kwan3217/rollercoasterometer/README.md

# rollercoasterometer
Rollercoasterometer
