kwan3217/rollercoasterometer/case/README.md

Design files for the case. Inkscape SVG for Ponoko, FreeCad for step export.
