kwan3217/rollercoasterometer/USB+ Breakout/README.md

# USB+ breakout
This is for *USB+*, which is designed to be USB 2.0, *plus* other stuff on the other pairs, using a USB 3.0 cable.

This board is intended to test the concept, by having a pocket and remote USB receptacle, with a 1.5m USB 3.0 cable
to be plugged into both.
