kwan3217/rollercoasterometer/ICM42688 breakout/README.md

# Breakout for ICM42688 sensor
A board was made from these files as they exist on 2022-04-14
