kwan3217/rollercoasterometer/kicad/README.md

# Folder for Kicad source code for rollercoasterometer boards
