kwan3217/rollercoasterometer/doc/New protection diode.png

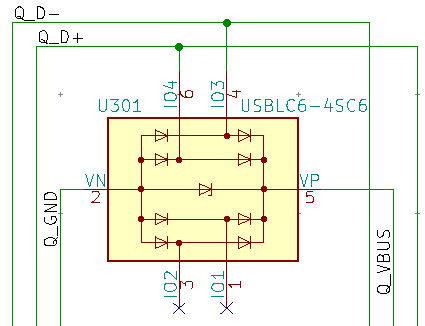
doc/New protection diode.png
