kwan3217/rollercoasterometer/doc/Protection diode routing.png

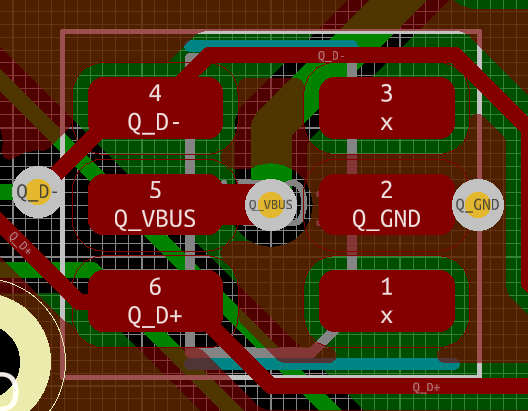
doc/Protection diode routing.png
