kwan3217/rollercoasterometer/case/Pocket Case.FCStd

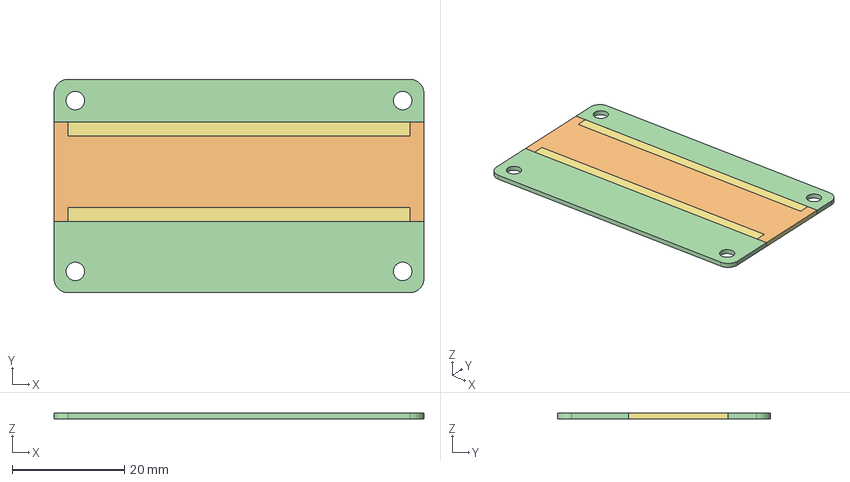
[picture p3: CAD file, 2022-04-28]
case/Pocket Case.FCStd
66.0 x 38.1 x 1.00 mm
EPlate
EThroughHoleSlots
EHoleUSBPlus
ESlot
EUSBSlot
EHole
EJoystick
