kwan3217/rollercoasterometer/kicad/joystick.step

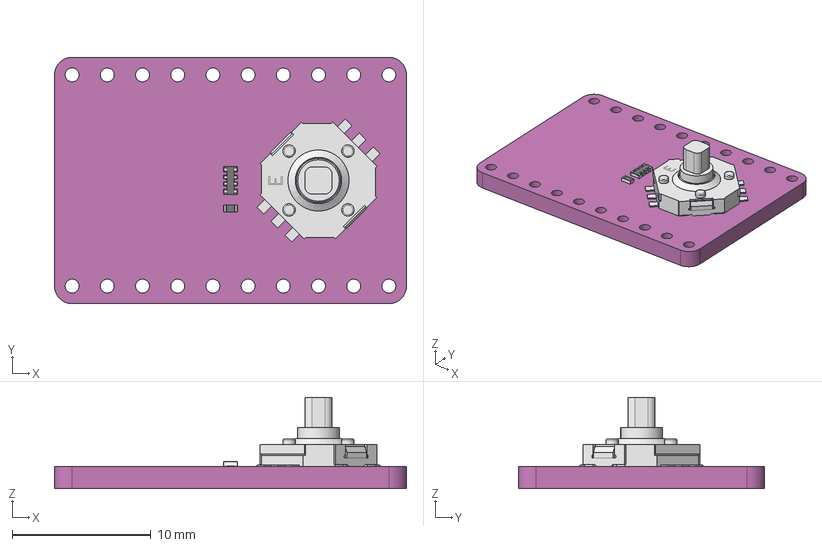
[picture p4: CAD file, 2022-04-25]
kicad/joystick.step
25.4 x 17.8 x 6.59 mm
Pcb_d5d7
S3501_JS1400BFQ_b402e1f153ac
R3502_R_0402_1005Metric_25f31b7644c3
R3501_R_Array_Convex_4x0402_d6afd14049a0
