kwan3217/rollercoasterometer/case/Pocket Case-Slot.step

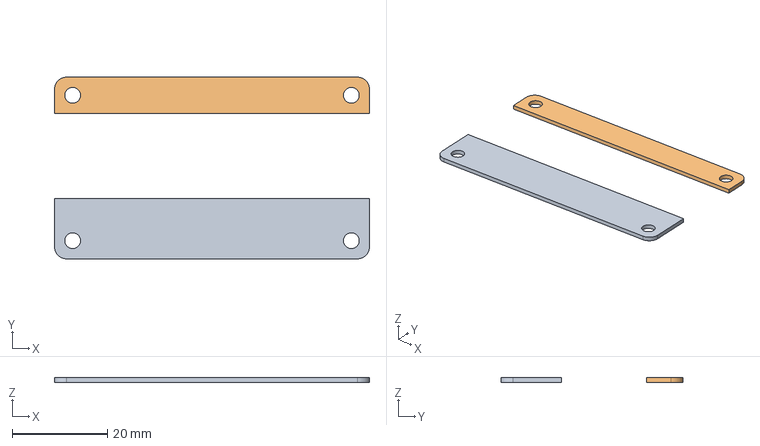
[picture p5: CAD file, 2022-04-28]
case/Pocket Case-Slot.step
66.0 x 38.1 x 1.00 mm
