kwan3217/rollercoasterometer/case/Pocket Case-Joystick.step

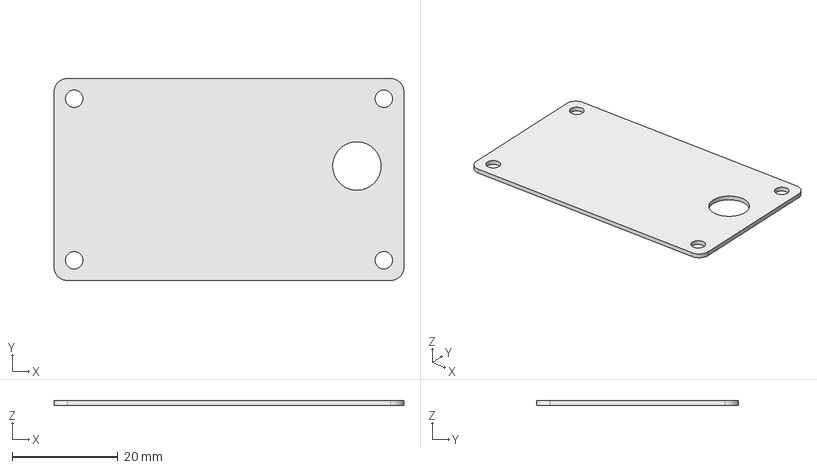
[picture p7: CAD file, 2022-04-28]
case/Pocket Case-Joystick.step
66.0 x 38.1 x 1.00 mm
