kwan3217/rollercoasterometer/case/Pocket Case-USBPlus.step

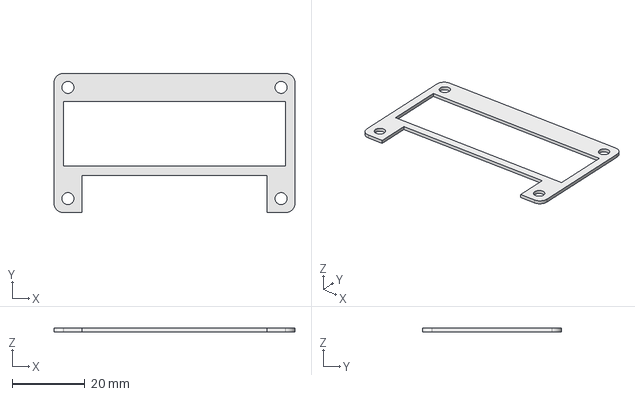
[picture p9: CAD file, 2022-04-28]
case/Pocket Case-USBPlus.step
66.0 x 38.1 x 1.00 mm
