kwan3217/rollercoasterometer/case/Pocket Case-USBSlot.step

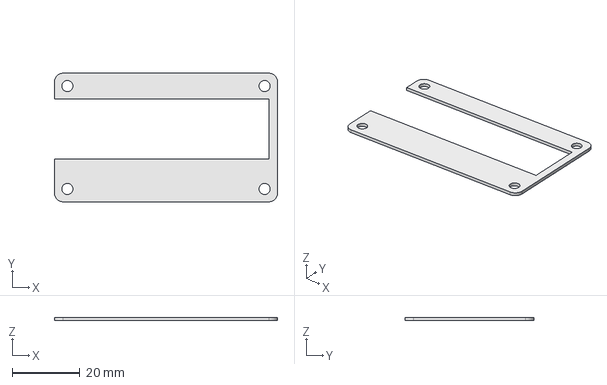
[picture p10: CAD file, 2022-04-28]
case/Pocket Case-USBSlot.step
66.0 x 38.1 x 1.00 mm
