kwan3217/rollercoasterometer/case/Pocket Case-Plate.step

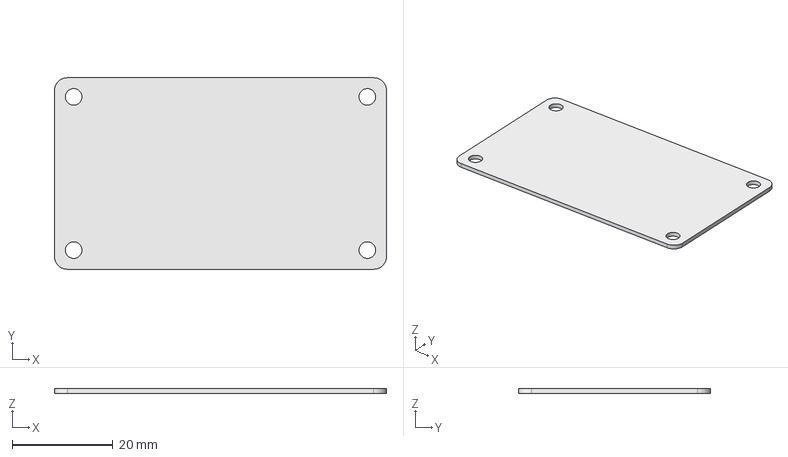
[picture p11: CAD file, 2022-04-28]
case/Pocket Case-Plate.step
66.0 x 38.1 x 1.00 mm
