kwan3217/rollercoasterometer/kicad/rollercoasterometer_hat/rollercoasterometer_hat.kicad_pcb

## KiCad design kicad/rollercoasterometer_hat/rollercoasterometer_hat.kicad_pcb (2022-12-18)

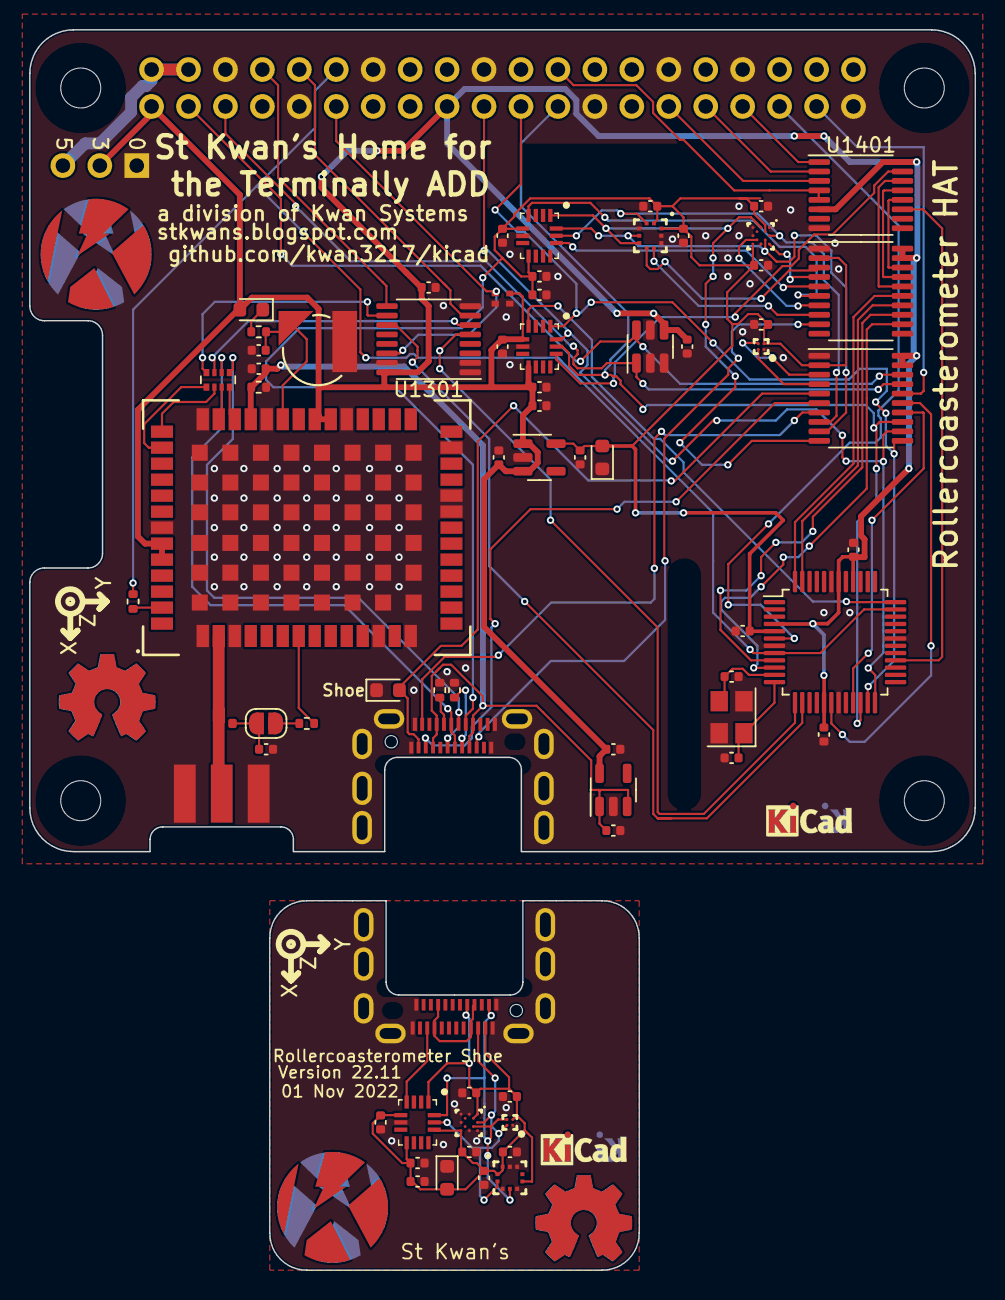
[picture p12: board rollercoasterometer_hat.kicad_pcb from above]

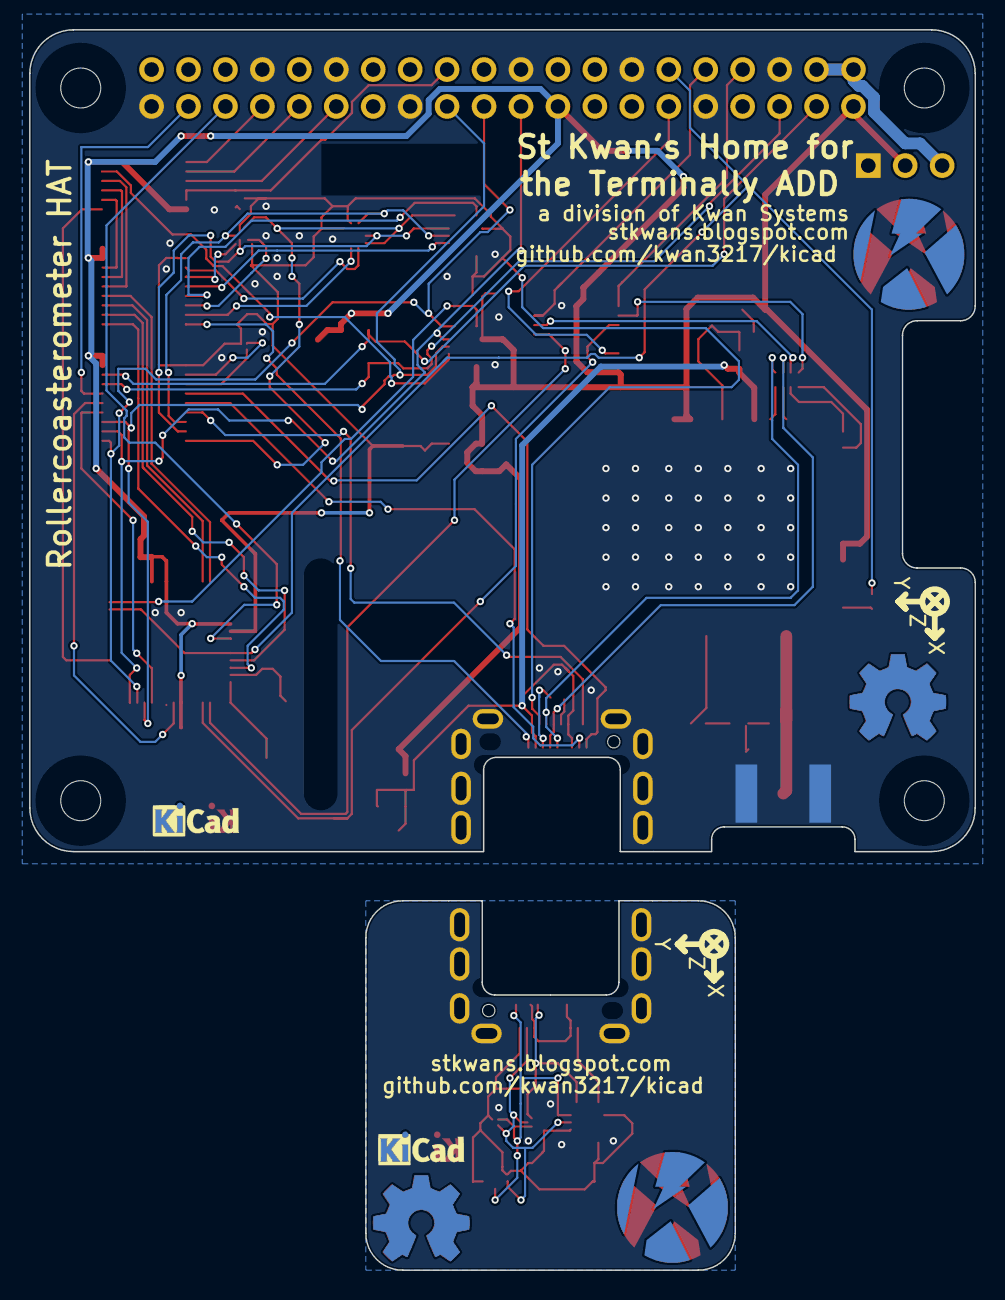
[picture p13: board rollercoasterometer_hat.kicad_pcb from below]

Board: 2 copper layers, 65.0 x 56.5 mm, 86 parts (6 on the bottom side), 73 nets.

Parts:
B201: ML414H; Coin_Cell_ML414H
C201: 47pF; C_0402_1005Metric
C236, C238, C401, C405, C501, C505: 1uF; C_0402_1005Metric
C605, C805, C1605: 10nF; C_0402_1005Metric
C606, C806, C1606: 2.2uF; C_0402_1005Metric
C608, C704, C808, C922, C955, C1011, C1101, C1110, C1205, C1217, C1240, C1301, C1608, C1722, C1755, C1811, C1901, C1910: 100nF; C_0402_1005Metric
C1211, C1212: 22pF; C_0402_1005Metric
D201: 0.5A/420mV; D_0603_1608Metric
D301, D302, D501: RED; LED_0603_1608Metric
G101, G1501: Axis
G102, G105, G1502, G1505: KwanSystems; StKwansSoldermask
G103, G107, G1503, G1507: DesignedWithKicad; Symbol_KiCAD-Logo_CopperAndSilkScreenTop_small
G104, G106, G1504, G1506: OSHW; OSHW-Symbol_6.7x6mm_SolderMask
J101: Raspberry_Pi_40; PiHAT
J102: Conn_01x03; PinHeader_1x03_P2.54mm_Horizontal
J201: SMA; SMA-EDGE
J202: NormallyClosed; SolderJumper-2_P1.3mm_MaskBridged_RoundedPad1.0x1.5mm
J301, J302: USB_C_Receptacle; USB_C_Amphenol_MidMount_with_cutout
L201: Ferrite 120NH; L_0402_1005Metric
R238: 100k; R_0402_1005Metric
R239: 27; R_Array_Convex_4x0402
R253, R407: 27; R_0402_1005Metric
R301, R302, R436: 5.1k; R_0402_1005Metric
R1301: 10k; R_Array_Convex_2x0402
U201: ZED_F9R; ZED-F9x
U401: TCR2EF 3.3V; SOT-23-5
U501: TCR2EF 1.8V; SOT-23-5
U601, U801, U1601: ICM-42688; QFN50P300X250X97-14N
U701: TLE493D-W2B6; SOT-23-6
U901, U1701: BMM150
U1001, U1801: AK09918; AK09918C
U1101, U1901: BMP384
U1201: LPC2103; LQFP-48_7x7mm_P0.5mm
U1301: 743253; TSSOP-16_4.4x5mm_P0.65mm
U1401: 74LS138; TSSOP-16_4.4x5mm_P0.65mm
U1402, U1403: TXS0108; TSSOP-20_4.4x6.5mm_P0.65mm
Y1201: 12MHz; Crystal_SMD_Abracon_ABM8G-4Pin_3.2x2.5mm

Connections:
+1V8: C505.1, C805.1, C806.1, C808.1, C922.1, C955.1, C1011.1, C1101.1, C1110.1, C1205.1, D501.2 (A), J301.A8 (SBU1), U501.5 (OUT), U801.5 (VDDIO), U801.8 (VDD), U901.B2 (VDDIO), U901.E5 (VDD), U1001.B1 (VDD), U1101.1 (VDDIO), U1101.10 (VDD), U1201.5 (VDD(1V8)), U1402.2 (VLO), U1403.2 (VLO)
+3V3: C405.1, C501.1, C605.1, C606.1, C608.1, C704.1, C1217.1, C1240.1, C1301.1, D201.2 (A), J101.1 (3V3), J101.17 (3V3), J102.2, R1301.4 (3), U201.33 (VCC), U201.34 (VCC), U201.49 (~RESET), U201.50 (~SAFEBOOT), U401.5 (OUT), U501.1 (IN), U501.3 (EN), U601.5 (VDDIO), U601.8 (VDD), U701.4 (VDD), U1201.4 (VBAT), U1201.17 (VDD(3V3)), U1201.40 (VDD(3V3)), U1201.42 (VDDA), U1301.16 (VCC), U1401.6 (E3), U1401.16 (VCC), U1402.19 (VHI), U1402.20 (EN), U1403.19 (VHI), U1403.20 (EN)
+5V: J101.2 (5V), J101.4 (5V), J102.3
/Bus Level Converter/~CS_6D18_3V3: U1401.14 (O1), U1402.16 (B3)
/Bus Level Converter/~CS_BMM_3V3: U1401.13 (O2), U1402.17 (B2)
/Bus Level Converter/~CS_BMP_3V3: U1401.12 (O3), U1402.18 (B1)
/CS0: J101.33 ((PWM1)_GPIO13), U1401.1 (A0)
/CS1: J101.31 (GPIO6), U1401.2 (A1)
/CS2: J101.29 (GPIO5), U1401.3 (A2)
/D+: J301.A6 (D+), J301.B6 (D+), R239.2 (4)
/D-: J301.A7 (D-), J301.B7 (D-), R239.1 (4)
/DRDY_6D18_1V8: U801.4 (INT1), U1402.6 (A4)
/DRDY_6D18_3V3: U1201.48 ((CAP1.3/SDA1)P0.18), U1402.15 (B4)
/DRDY_6D33_3V3: U601.4 (INT1), U1201.36 ((CTS1/CAP1.1/AD0.4)P0.11)
/DRDY_BMM_1V8: U901.D4 (DRDY), U1402.7 (A5)
/DRDY_BMM_3V3: U1201.47 ((CAP1.2/SCL1)P0.17), U1402.14 (B5)
/DRDY_BMP_1V8: U1101.7 (INT), U1402.8 (A6)
/DRDY_BMP_3V3: U1201.9 ((TMS/CAP2.1)P0.28), U1402.13 (B6)
/GPS/DM-: R239.8 (5), U201.39 (USB_D-)
/GPS/DP-: R239.7 (5), U201.40 (USB_D+)
/GPS/RF_IN: J201.1 (In), L201.1, U201.2 (RF_IN)
/GPS/RX/MOSI-: R239.5, U201.43 (RX/MOSI)
/GPS/TIMEPULSE-: R253.1, U201.53 (TIMEPULSE)
/GPS/TX/MISO-: R239.6 (5), U201.42 (TX/MISO)
/GPS/VBAT+: D201.1 (K), R436.1
/GPS/V_BATT: B201.1 (+), C236.1, R436.2, U201.36 (V_BKCP)
/GPS/V_RF: R407.2, U201.7 (VCC_RF)
/GPS/V_RF-: J202.2 (B), R407.1
/GPS/V_RF--: C201.1, J202.1 (A), L201.2
/GPS_RX: R239.4, U1301.10 (2B1)
/GPS_TX: R239.3 (4), U1301.6 (1B1)
/LPC_RX: U1201.14 ((RXD0/MAT3.2)P0.1), U1301.11 (2B2)
/LPC_TX: U1201.13 ((TXD0/MAT3.1)P0.0), U1301.5 (1B2)
/LPC_~RESET: J101.35 ((MISO)_GPIO19), U1201.6 (~RST)
/MISO_1V8: U801.1 (AD0), U901.C1 (SDO), U1101.5 (SDO), U1403.10 (A8)
/MISO_3V3: J101.21 ((SPI_MISO)_GPIO9), U601.1 (AD0), U1201.23 ((MISO0/MAT0.1)P0.5), U1403.11 (B8)
/MOSI_1V8: U801.14 (SDA), U901.B4 (SDI), U1101.4 (SDI), U1403.9 (A7)
/MOSI_3V3: J101.19 ((SPI_MOSI)_GPIO10), U601.14 (SDA), U1201.24 ((MOSI0/CAP0.2)P0.6), U1403.12 (B7)
/PPS: J101.12 (GPIO18_(GEN1)), R253.2, U1201.8 ((~TRST/CAP2.0)P0.27), U1201.35 ((RTS1/CAP1.0/AD0.3)P0.10)
/P_RET_1V8: D301.2 (A), J301.B11 (RX1+), U1403.5 (A3)
/P_RET_3V3: J101.37 (GPIO26), U1403.16 (B3)
/Q_1V8: C1605.1, C1606.1, C1608.1, C1722.1, C1755.1, C1811.1, C1901.1, C1910.1, D302.2 (A), J302.A2 (TX1+), J302.B8 (SBU2), U1601.1 (AD0), U1601.5 (VDDIO), U1601.8 (VDD), U1601.12 (~CS), U1701.A1 (PS), U1701.B2 (VDDIO), U1701.E5 (VDD), U1801.B1 (VDD), U1901.1 (VDDIO), U1901.6 (CSB), U1901.10 (VDD)
/Q_GND: C1605.2, C1606.2, C1608.2, C1722.2, C1755.2, C1811.2, C1901.2, C1910.2, D302.1 (K), J302.A1 (GND), J302.A12 (GND), J302.B1 (GND), J302.B12 (GND), J302.S1 (SHIELD), U1601.6 (GND), U1701.A5 (CSB), U1701.C1 (SDO), U1701.C5 (GND), U1701.E1 (GND), U1701.E3 (GND), U1801.A1 (VSS), U1901.3 (VSS), U1901.5 (SDO), U1901.8 (VSS), U1901.9 (VSS)
/Q_SCL_1V8: J302.A3 (TX1-), U1601.13 (SCL), U1701.A3 (SCK), U1801.A2 (SCL), U1901.2 (SCK)
/Q_SDA_1V8: J302.B11 (RX1+), U1601.14 (SDA), U1701.B4 (SDI), U1801.B2 (SDA), U1901.4 (SDI)
/Q_SHOE_INT: J302.A10 (RX2-), U1601.4 (INT1)
/RX_PI: J101.10 ((RXD0)_GPIO15), U1301.7 (1A)
/SCK_1V8: U801.13 (SCL), U901.A3 (SCK), U1101.2 (SCK), U1403.8 (A6)
/SCK_3V3: J101.23 ((SPI_SCLK)_GPIO11), U601.13 (SCL), U1201.22 ((SCK0/CAP0.1)P0.4), U1403.13 (B6)
/SCL_LPC_1V8: J301.B10 (RX1-), U1403.6 (A4)
/SCL_LPC_3V3: U1201.18 ((SCL0/CAP0.0)P0.2), U1403.15 (B4)
/SCL_PI_1V8: U1001.A2 (SCL), U1403.4 (A2)
/SCL_PI_3V3: J101.5 ((SCL1)_GPIO3), U701.1 (SCL/INT), U1403.17 (B2)
/SDA_LPC_1V8: J301.A2 (TX1+), U1403.7 (A5)
/SDA_LPC_3V3: U1201.21 ((SDA0/MAT0.0)P0.3), U1403.14 (B5)
/SDA_PI_1V8: U1001.B2 (SDA), U1403.3 (A1)
/SDA_PI_3V3: J101.3 ((SDA1)_GPIO2), U701.6 (SDA), U1403.18 (B1)
/SHOE_INT_1V8: J301.B3 (TX2-), U1402.9 (A7)
/SHOE_INT_3V3: U1201.10 ((TCK/CAP2.2)P0.29), U1402.12 (B7)
/TX_PI: J101.8 ((TXD0)_GPIO14), U1301.9 (2A)
/Timer/XTAL1: C1211.2, U1201.11 (XTAL1), Y1201.3
/Timer/XTAL2: C1212.2, U1201.12 (XTAL2), Y1201.1
/UART_S0: J101.11 (GPIO17_(GEN0)), R1301.1 (4), U1301.14 (S0)
/USB+ Cable/P_CC1: J301.A5 (CC1), R302.2
/USB+ Cable/P_CC2: J301.B5 (CC2), R301.2
/VBUS: C238.1, C401.1, J301.A4 (VBUS), J301.A9 (VBUS), J301.B4 (VBUS), J301.B9 (VBUS), R238.2, U201.38 (V_USB), U401.1 (IN), U401.3 (EN)
/~CE0: J101.24 ((~SPI_CE0)_GPIO8), U1401.4 (E1), U1401.5 (E2)
/~CS_6D18_1V8: U801.12 (~CS), U1402.5 (A3)
/~CS_6D33: U601.12 (~CS), U1401.15 (O0)
/~CS_BMM_1V8: U901.A5 (CSB), U1402.4 (A2)
/~CS_BMP_1V8: U1101.6 (CSB), U1402.3 (A1)
/~CS_LPC_3V3: U1201.28 ((SSEL0/MAT2.0)P0.7), U1401.11 (O4)
GND: B201.2 (-), C201.2, C236.2, C238.2, C401.2, C405.2, C501.2, C505.2, C605.2, C606.2, C608.2, C704.2, C805.2, C806.2, C808.2, C922.2, C955.2, C1011.2, C1101.2, C1110.2, C1205.2, C1211.1, C1212.1, C1217.2, C1240.2, C1301.2, D301.1 (K), D501.1 (K), J101.6 (GND), J101.9 (GND), J101.14 (GND), J101.20 (GND), J101.25 (GND), J101.30 (GND), J101.34 (GND), J101.39 (GND), J102.1, J201.2 (Ext), J301.A1 (GND), J301.A12 (GND), J301.B1 (GND), J301.B12 (GND), J301.S1 (SHIELD), R238.1, R301.1, R302.1, R1301.2 (4), R1301.3, U201.1 (GND), U201.3 (GND), U201.12 (GND), U201.14 (GND), U201.22 (WT), U201.23 (DIR), U201.26 (RX2), U201.32 (GND), U201.37 (GND), U201.41 (GND), U201.48 (GND), U201.PAD (GND), U401.2 (GND), U501.2 (GND), U601.6 (GND), U701.2 (GND), U701.3 (GND), U701.5 (GND), U801.6 (GND), U901.A1 (PS), U901.C5 (GND), U901.E1 (GND), U901.E3 (GND), U1001.A1 (VSS), U1101.3 (VSS), U1101.8 (VSS), U1101.9 (VSS), U1201.7 (VSS), U1201.19 (VSS), U1201.31 (VSSA), U1201.43 (VSS), U1301.1 (1~OE), U1301.2 (S1), U1301.8 (GND), U1301.15 (2~OE), U1401.8 (GND), U1402.1 (GND), U1403.1 (GND), Y1201.2, Y1201.4
