kwan3217/rollercoasterometer/kicad/rollercoasterometer.kicad_pcb

## KiCad design kicad/rollercoasterometer.kicad_pcb (2022-12-18)

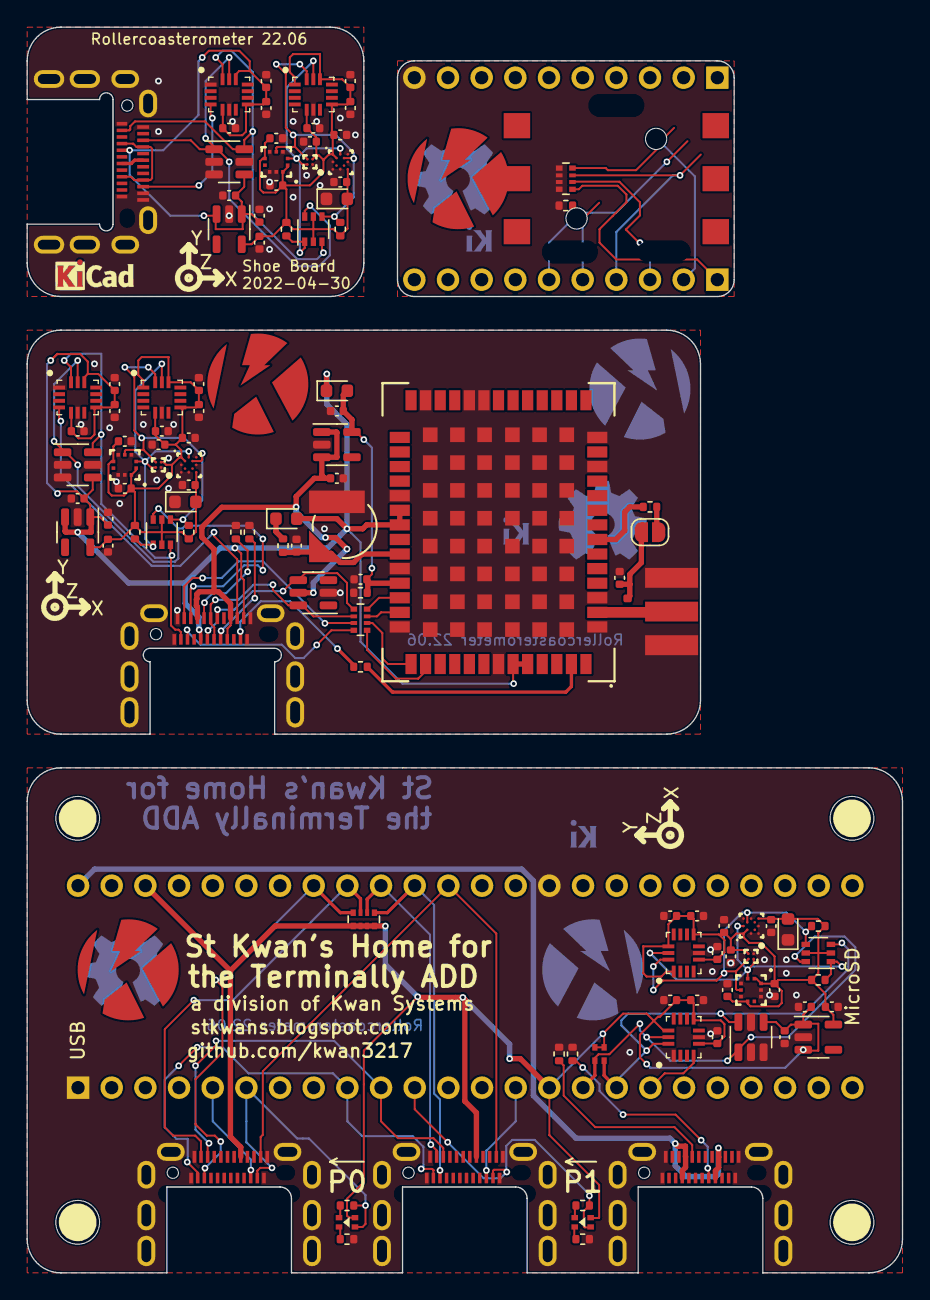
[picture p14: board rollercoasterometer.kicad_pcb from above]

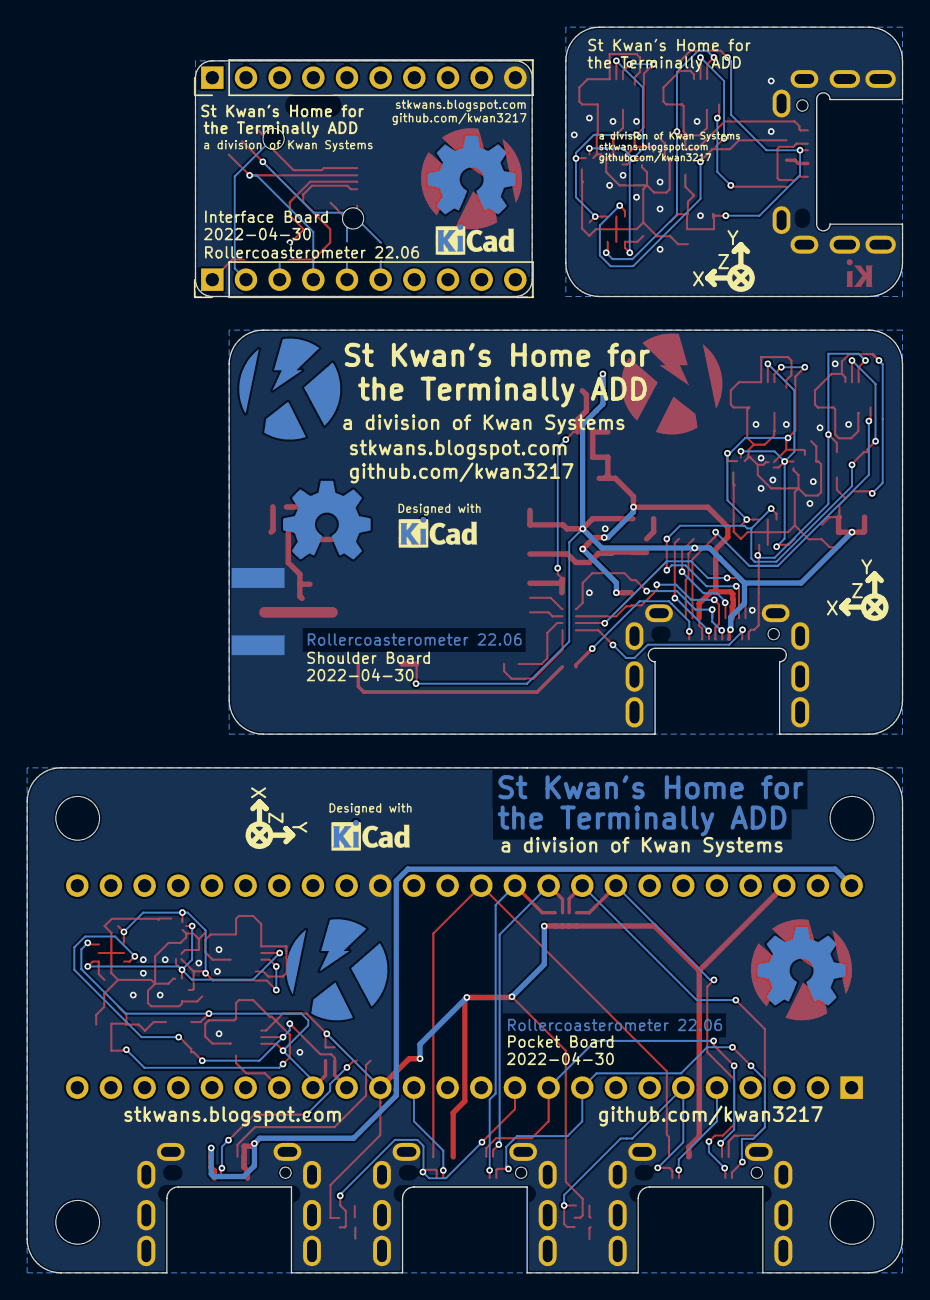
[picture p15: board rollercoasterometer.kicad_pcb from below]

Board: 2 copper layers, 66.0 x 94.0 mm, 136 parts (10 on the bottom side), 72 nets.

Parts:
B401: ML414H; Coin_Cell_ML414H
C205, C1205, C1305, C2105, C2705, C3205: 10nF; C_0402_1005Metric
C206, C1206, C1306, C2106, C2706, C3206: 2.2uF; C_0402_1005Metric
C208, C611, C704, C901, C910, C1122, C1155, C1208, C1308, C1804, C2108, C2322, C2355, C2411, C2501, C2510, C2708, C2804, C2901, C2910, C3208, C3322, C3355, C3411: 100nF; C_0402_1005Metric
C401: 47pF; C_0402_1005Metric
C436, C438, C501, C505, C1001, C1005, C1901, C1905, C3001, C3005: 1uF; C_0402_1005Metric
D338, D401: 0.5A/420mV; D_0603_1608Metric
D1001, D1905, D3001: RED; LED_0603_1608Metric
D1401, D1601: GREEN, YELLOW; LEDKingbrightAPHB
G101, G102, G301, G302, G3502: KwanSystems; StKwansSoldermask
G103, G303, G1501, G3503: DesignedWithKicad; Symbol_KiCAD-Logo_CopperAndSilkScreenTop_small
G104, G304, G3504: OSHW; OSHW-Symbol_6.7x6mm_SolderMask
G105, G305, G1505: Axis
J101, J1401, J1402, J1601, J1602: USB_C_Receptacle; USB_C_Amphenol_MidMount
J120, J125, J127, J129: STANDOFF; STANDOFF_NONPLATED
J401: SMA; SMA-EDGE
J402: NormallyClosed; SolderJumper-2_P1.3mm_MaskBridged_RoundedPad1.0x1.5mm
J3501, J3502: Conn_01x10; PinHeader_1x10_P2.54mm_Vertical
L401: Ferrite 120NH; L_0402_1005Metric
Q801, Q2001, Q3101: NMOS; SOT-363_SC-70-6
R101, R102, R301, R302, R436, R801, R802, R2001, R2002, R3101, R3102, R3502: 5.1k; R_0402_1005Metric
R116: 2.2k; R_Array_Convex_2x0402
R138, R3501: 2.2k; R_Array_Convex_4x0402
R407, R453: 27; R_0402_1005Metric
R438: 100k; R_0402_1005Metric
R439: 27; R_Array_Convex_4x0402
R1401, R1601: 330; R_0402_1005Metric
R1402, R1602: 1.5k; R_0402_1005Metric
S3501: JS5208
U104: Teensy4.1; Teensy2x24
U201, U1201, U1301, U2101, U2701, U3201: ICM-42688; QFN50P300X250X97-14N
U301: USBLC6-4SC6; SOT-23-6
U401: ZED_F9R; ZED-F9x
U501: TCR2EF 3.3V; SOT-23-5
U601, U2401, U3401: AK09918; AK09918C
U704, U1801, U2801: TLE493D-W2B6; SOT-23-6
U901, U2501, U2901: BMP384
U1001, U1901, U3001: TCR2EF 1.8V; SOT-23-5
U1101, U2201, U3301: BMM150

Connections:
+3V3: C2705.1, C2706.1, C2708.1, C2804.1, C3001.1, D1401.3 (A2), D1601.3 (A2), J1401.A8 (SBU1), J1601.A8 (SBU1), R116.3, R116.4 (3), R138.5, R138.6 (5), R138.7 (5), R138.8 (5), U104.15 (+3V3), U104.46 (+3V3), U2701.5 (VDDIO), U2701.8 (VDD), U2701.12 (~CS), U2801.4 (VDD), U3001.1 (IN), U3001.3 (EN)
+5V: J101.A4 (VBUS), J101.A9 (VBUS), J101.B4 (VBUS), J101.B9 (VBUS), U104.48 (Vin)
/CC1: J101.A5 (CC1), R101.2
/CC2: J101.B5 (CC2), R102.2
/Joystick/Q_3V3: J3501.6, S3501.COM
/Joystick/Q_DOWN: J3501.3, R3501.6 (5), S3501.C
/Joystick/Q_GND: J3502.10, R3501.1 (4), R3501.2 (4), R3501.3 (4), R3501.4, R3502.1
/Joystick/Q_LEFT: J3501.5, R3502.2, S3501.A
/Joystick/Q_PUSH: J3501.1, R3501.5, S3501.PUSH
/Joystick/Q_RIGHT: J3501.4, R3501.7 (5), S3501.D
/Joystick/Q_UP: J3501.2, R3501.8 (5), S3501.B
/P0_ID: D1401.1 (A1), J1401.B2 (TX2+), R1402.2, U104.6 (D4~)
/P0_INT: J1401.B3 (TX2-), U104.5 (D3~)
/P0_SCL: J1401.B10 (RX1-), R138.4, U104.41 (~D19)
/P0_SDA: J1401.A2 (TX1+), R138.3 (4), U104.40 (~D18)
/P1_ID: D1601.1 (A1), J1601.B2 (TX2+), R1602.2, U104.11 (D9~)
/P1_INT: J1601.B3 (TX2-), U104.14 (D12~)
/P1_SCL: J1601.B10 (RX1-), R138.1 (4), U104.38 (D16)
/P1_SDA: J1601.A2 (TX1+), R138.2 (4), U104.39 (D17)
/P2_INT: U104.18 (D26), U2701.4 (INT1)
/P2_SCL: Q3101.6 (D), R116.1 (4), U104.16 (D24~), U2701.13 (SCL), U2801.1 (SCL/INT)
/P2_SDA: Q3101.3 (D), R116.2 (4), U104.17 (D25~), U2701.14 (SDA), U2801.6 (SDA)
/PPS: J1401.A11 (RX2+), J1601.A11 (RX2+), U104.37 (~D15)
/Pocket Sensor Block/Q_1V8: C2901.1, C2910.1, C3005.1, C3205.1, C3206.1, C3208.1, C3322.1, C3355.1, C3411.1, D3001.2 (A), Q3101.2 (G), Q3101.5 (G), R3101.2, R3102.2, U2901.1 (VDDIO), U2901.6 (CSB), U2901.10 (VDD), U3001.5 (OUT), U3201.1 (AD0), U3201.5 (VDDIO), U3201.8 (VDD), U3201.12 (~CS), U3301.A1 (PS), U3301.B2 (VDDIO), U3301.E5 (VDD), U3401.B1 (VDD)
/Pocket Sensor Block/SCL_1V8: Q3101.1 (S), R3102.1, U2901.2 (SCK), U3201.13 (SCL), U3301.A3 (SCK), U3401.A2 (SCL)
/Pocket Sensor Block/SDA_1V8: Q3101.4 (S), R3101.1, U2901.4 (SDI), U3201.14 (SDA), U3301.B4 (SDI), U3401.B2 (SDA)
/RX_GPS: J1401.A3 (TX1-), J1601.A3 (TX1-), U104.10 (D8~)
/Shoe/Q_3V3: C205.1, C206.1, C208.1, C1804.1, C1901.1, J1402.B8 (SBU2), U201.5 (VDDIO), U201.8 (VDD), U201.12 (~CS), U1801.4 (VDD), U1901.1 (IN), U1901.3 (EN)
/Shoe/Q_GND: C205.2, C206.2, C208.2, C1804.2, C1901.2, C1905.2, C2105.2, C2106.2, C2108.2, C2322.2, C2355.2, C2411.2, C2501.2, C2510.2, D1905.1 (K), J1402.A1 (GND), J1402.A11 (RX2+), J1402.A12 (GND), J1402.B1 (GND), J1402.B12 (GND), J1402.S1 (SHIELD), U201.1 (AD0), U201.6 (GND), U1801.2 (GND), U1801.3 (GND), U1801.5 (GND), U1901.2 (GND), U2101.6 (GND), U2201.A5 (CSB), U2201.C1 (SDO), U2201.C5 (GND), U2201.E1 (GND), U2201.E3 (GND), U2401.A1 (VSS), U2501.3 (VSS), U2501.5 (SDO), U2501.8 (VSS), U2501.9 (VSS)
/Shoe/Q_INT: J1402.A10 (RX2-), U201.4 (INT1)
/Shoe/Q_SCL: J1402.A3 (TX1-), Q2001.6 (D), U201.13 (SCL), U1801.1 (SCL/INT)
/Shoe/Q_SDA: J1402.B11 (RX1+), Q2001.3 (D), U201.14 (SDA), U1801.6 (SDA)
/Shoe/Sensor Block/Q_1V8: C1905.1, C2105.1, C2106.1, C2108.1, C2322.1, C2355.1, C2411.1, C2501.1, C2510.1, D1905.2 (A), Q2001.2 (G), Q2001.5 (G), R2001.2, R2002.2, U1901.5 (OUT), U2101.1 (AD0), U2101.5 (VDDIO), U2101.8 (VDD), U2101.12 (~CS), U2201.A1 (PS), U2201.B2 (VDDIO), U2201.E5 (VDD), U2401.B1 (VDD), U2501.1 (VDDIO), U2501.6 (CSB), U2501.10 (VDD)
/Shoe/Sensor Block/SCL_1V8: Q2001.1 (S), R2002.1, U2101.13 (SCL), U2201.A3 (SCK), U2401.A2 (SCL), U2501.2 (SCK)
/Shoe/Sensor Block/SDA_1V8: Q2001.4 (S), R2001.1, U2101.14 (SDA), U2201.B4 (SDI), U2401.B2 (SDA), U2501.4 (SDI)
/Shoe/USB+ cable/DG-: D1401.2 (K1), R1401.1
/Shoe/USB+ cable/DY-: D1401.4 (K2), R1402.1
/Shoe/USB+ cable/Q_D+: J1402.A6 (D+), J1402.B6 (D+)
/Shoe/USB+ cable/Q_D-: J1402.A7 (D-), J1402.B7 (D-)
/Shoe/USB+ cable/Q_VBUS: J1402.A4 (VBUS), J1402.A9 (VBUS), J1402.B4 (VBUS), J1402.B9 (VBUS)
/Shoulder/GPS Rover/DM-: R439.8 (5), U401.39 (USB_D-)
/Shoulder/GPS Rover/DP-: R439.7 (5), U401.40 (USB_D+)
/Shoulder/GPS Rover/RF_IN: J401.1 (In), L401.1, U401.2 (RF_IN)
/Shoulder/GPS Rover/RX/MOSI-: R439.5, U401.43 (RX/MOSI)
/Shoulder/GPS Rover/TIMEPULSE-: R453.1, U401.53 (TIMEPULSE)
/Shoulder/GPS Rover/TX/MISO-: R439.6 (5), U401.42 (TX/MISO)
/Shoulder/GPS Rover/VBAT+: D401.1 (K), R436.1
/Shoulder/GPS Rover/V_BATT: B401.1 (+), C436.1, R436.2, U401.36 (V_BKCP)
/Shoulder/GPS Rover/V_RF: R407.2, U401.7 (VCC_RF)
/Shoulder/GPS Rover/V_RF-: J402.2 (B), R407.1
/Shoulder/GPS Rover/V_RF--: C401.1, J402.1 (A), L401.2
/Shoulder/Q_3V3: C704.1, C1001.1, C1305.1, C1306.1, C1308.1, D338.1 (K), D401.2 (A), J1602.A11 (RX2+), J1602.B8 (SBU2), U401.33 (VCC), U401.34 (VCC), U401.49 (~RESET), U401.50 (~SAFEBOOT), U704.4 (VDD), U1001.1 (IN), U1001.3 (EN), U1301.5 (VDDIO), U1301.8 (VDD), U1301.12 (~CS)
/Shoulder/Q_CC1: J1602.A5 (CC1), R301.1
/Shoulder/Q_CC2: J1602.B5 (CC2), R302.1
/Shoulder/Q_D+: J1602.A6 (D+), J1602.B6 (D+), R439.2 (4), U301.6 (IO4)
/Shoulder/Q_D-: J1602.A7 (D-), J1602.B7 (D-), R439.1 (4), U301.4 (IO3)
/Shoulder/Q_GND: B401.2 (-), C401.2, C436.2, C438.2, C501.2, C505.2, C611.2, C704.2, C901.2, C910.2, C1001.2, C1005.2, C1122.2, C1155.2, C1205.2, C1206.2, C1208.2, C1305.2, C1306.2, C1308.2, D1001.1 (K), J401.2 (Ext), J1602.A1 (GND), J1602.A12 (GND), J1602.B1 (GND), J1602.B12 (GND), J1602.S1 (SHIELD), R301.2, R302.2, R438.1, U301.2 (VN), U401.1 (GND), U401.3 (GND), U401.12 (GND), U401.14 (GND), U401.22 (WT), U401.23 (DIR), U401.26 (RX2), U401.32 (GND), U401.37 (GND), U401.41 (GND), U401.48 (GND), U401.PAD (GND), U501.2 (GND), U601.A1 (VSS), U704.2 (GND), U704.3 (GND), U704.5 (GND), U901.3 (VSS), U901.5 (SDO), U901.8 (VSS), U901.9 (VSS), U1001.2 (GND), U1101.A5 (CSB), U1101.C1 (SDO), U1101.C5 (GND), U1101.E1 (GND), U1101.E3 (GND), U1201.6 (GND), U1301.1 (AD0), U1301.6 (GND)
/Shoulder/Q_INT: J1602.A10 (RX2-), U1301.4 (INT1)
/Shoulder/Q_PPS: J1602.B2 (TX2+), R453.2
/Shoulder/Q_RX_GPS: J1602.B10 (RX1-), R439.4
/Shoulder/Q_SCL: J1602.A3 (TX1-), Q801.6 (D), U704.1 (SCL/INT), U1301.13 (SCL)
/Shoulder/Q_SDA: J1602.B11 (RX1+), Q801.3 (D), U704.6 (SDA), U1301.14 (SDA)
/Shoulder/Q_TX_GPS: J1602.A2 (TX1+), R439.3 (4)
/Shoulder/Q_VBUS: C501.1, J1602.A4 (VBUS), J1602.A9 (VBUS), J1602.B4 (VBUS), J1602.B9 (VBUS), U301.5 (VP), U501.1 (IN), U501.3 (EN)
/Shoulder/Sensor Block/Q_1V8: C611.1, C901.1, C910.1, C1005.1, C1122.1, C1155.1, C1205.1, C1206.1, C1208.1, D1001.2 (A), Q801.2 (G), Q801.5 (G), R801.2, R802.2, U601.B1 (VDD), U901.1 (VDDIO), U901.6 (CSB), U901.10 (VDD), U1001.5 (OUT), U1101.A1 (PS), U1101.B2 (VDDIO), U1101.E5 (VDD), U1201.1 (AD0), U1201.5 (VDDIO), U1201.8 (VDD), U1201.12 (~CS)
/Shoulder/Sensor Block/SCL_1V8: Q801.1 (S), R802.1, U601.A2 (SCL), U901.2 (SCK), U1101.A3 (SCK), U1201.13 (SCL)
/Shoulder/Sensor Block/SDA_1V8: Q801.4 (S), R801.1, U601.B2 (SDA), U901.4 (SDI), U1101.B4 (SDI), U1201.14 (SDA)
/Shoulder/USB+ cable/DG-: D1601.2 (K1), R1601.1
/Shoulder/USB+ cable/DY-: D1601.4 (K2), R1602.1
/Shoulder/V_USBDETECT: C438.1, C505.1, D338.2 (A), R438.2, U401.38 (V_USB), U501.5 (OUT)
/TX_GPS: J1401.B11 (RX1+), J1601.B11 (RX1+), U104.9 (D7~)
GND: C2705.2, C2706.2, C2708.2, C2804.2, C2901.2, C2910.2, C3001.2, C3005.2, C3205.2, C3206.2, C3208.2, C3322.2, C3355.2, C3411.2, D3001.1 (K), J101.A1 (GND), J101.A12 (GND), J101.B1 (GND), J101.B12 (GND), J101.S1 (SHIELD), J1401.A1 (GND), J1401.A12 (GND), J1401.B1 (GND), J1401.B12 (GND), J1401.S1 (SHIELD), J1601.A1 (GND), J1601.A12 (GND), J1601.B1 (GND), J1601.B12 (GND), J1601.S1 (SHIELD), R101.1, R102.1, R1401.2, R1601.2, U104.1 (GND), U104.34 (GND), U2701.1 (AD0), U2701.6 (GND), U2801.2 (GND), U2801.3 (GND), U2801.5 (GND), U2901.3 (VSS), U2901.5 (SDO), U2901.8 (VSS), U2901.9 (VSS), U3001.2 (GND), U3201.6 (GND), U3301.A5 (CSB), U3301.C1 (SDO), U3301.C5 (GND), U3301.E1 (GND), U3301.E3 (GND), U3401.A1 (VSS)
