kwan3217/rollercoasterometer/USB+ Breakout/USB+ Breakout.kicad_pcb

## KiCad design USB+ Breakout/USB+ Breakout.kicad_pcb (2022-04-25)

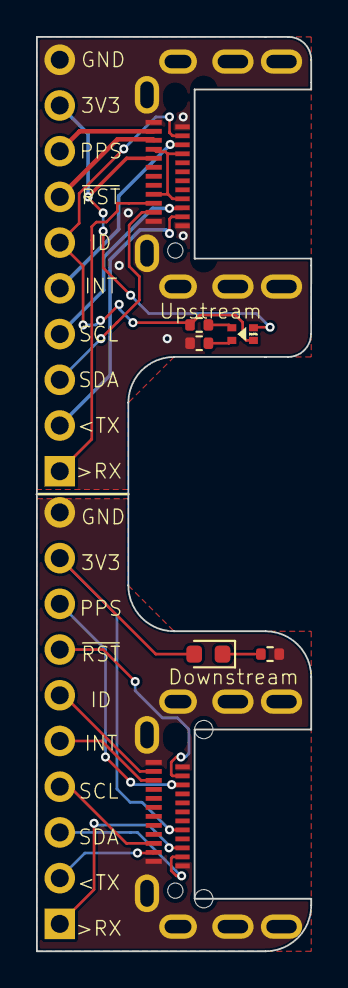
[picture p16: board USB+ Breakout.kicad_pcb from above]

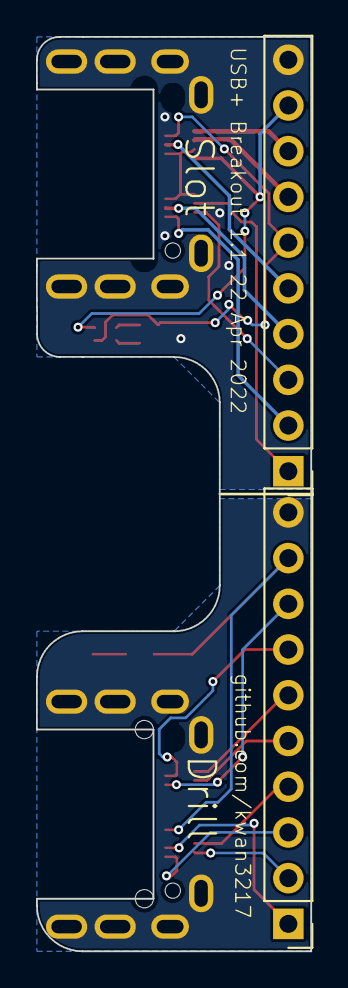
[picture p17: board USB+ Breakout.kicad_pcb from below]

Board: 2 copper layers, 15.2 x 50.8 mm, 9 parts (2 on the bottom side), 26 nets.

Parts:
D301: RED; LED_0603_1608Metric
D1601: GREEN, YELLOW; LEDKingbrightAPHB
J101, J301: Conn_01x10; PinHeader_1x10_P2.54mm_Vertical
J1601, J1602: USB_C_Receptacle; USB_C_Amphenol_MidMount
R301, R1602: 1.5k; R_0402_1005Metric
R1601: 330; R_0402_1005Metric

Connections:
/USB Cable/DG-: D1601.2 (K1), R1601.1
/USB Cable/DY-: D1601.4 (K2), R1602.1
/USB Cable/P_3V3: D1601.3 (A2), J101.9, J1601.A8 (SBU1)
/USB Cable/P_GND: J101.10, J1601.A1 (GND), J1601.A12 (GND), J1601.B1 (GND), J1601.B12 (GND), J1601.S1 (SHIELD), R1601.2
/USB Cable/P_ID: D1601.1 (A1), J101.6, J1601.B2 (TX2+), R1602.2
/USB Cable/P_INT: J101.5, J1601.B3 (TX2-)
/USB Cable/P_M~RST: J101.7, J1601.A10 (RX2-)
/USB Cable/P_PPS: J101.8, J1601.A11 (RX2+)
/USB Cable/P_RX_GPS: J101.1, J1601.A3 (TX1-)
/USB Cable/P_SCL: J101.4, J1601.B10 (RX1-)
/USB Cable/P_SDA: J101.3, J1601.A2 (TX1+)
/USB Cable/P_TX_GPS: J101.2, J1601.B11 (RX1+)
/USB Cable/Q_3V3: D301.2 (A), J301.9, J1602.B8 (SBU2)
/USB Cable/Q_D+: J1602.A6 (D+), J1602.B6 (D+)
/USB Cable/Q_D-: J1602.A7 (D-), J1602.B7 (D-)
/USB Cable/Q_GND: J301.10, J1602.A1 (GND), J1602.A12 (GND), J1602.B1 (GND), J1602.B12 (GND), J1602.S1 (SHIELD), R301.1
/USB Cable/Q_ID: J301.6, J1602.A11 (RX2+)
/USB Cable/Q_INT: J301.5, J1602.A10 (RX2-)
/USB Cable/Q_M~RST: J301.8, J1602.B3 (TX2-)
/USB Cable/Q_PPS: J301.7, J1602.B2 (TX2+)
/USB Cable/Q_RX_GPS: J301.1, J1602.B10 (RX1-)
/USB Cable/Q_SCL: J301.4, J1602.A3 (TX1-)
/USB Cable/Q_SDA: J301.3, J1602.B11 (RX1+)
/USB Cable/Q_TX_GPS: J301.2, J1602.A2 (TX1+)
/USB Cable/Q_VBUS: J1602.A4 (VBUS), J1602.A9 (VBUS), J1602.B4 (VBUS), J1602.B9 (VBUS)
unnamed: D301.1 (K), R301.2
