kwan3217/rollercoasterometer/ICM42688 breakout/ICM42688 breakout.kicad_pcb

## KiCad design ICM42688 breakout/ICM42688 breakout.kicad_pcb (2022-04-15)

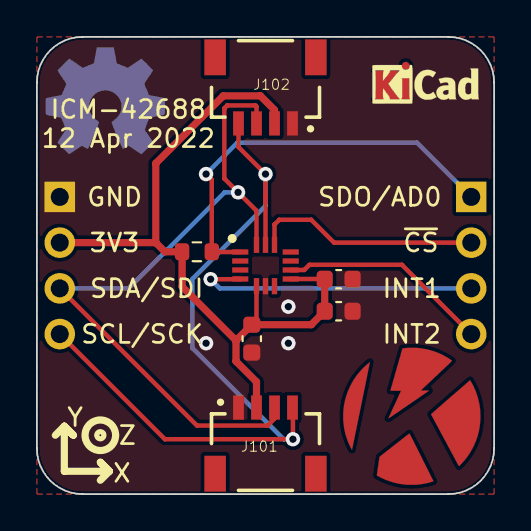
[picture p18: board ICM42688 breakout.kicad_pcb from above]

Board: 2 copper layers, 25.4 x 25.4 mm, 10 parts (0 on the bottom side), 8 nets.

Parts:
C105: 10nF; C_0603_1608Metric
C106: 2.2uF; C_0603_1608Metric
C108: 100nF; C_0603_1608Metric
J101, J102: 1x04 1mm; JST04_1MM_RA
J103, J104: Conn_01x04; PinHeader_1x04_P2.54mm_Vertical
R101: 10k; R_0603_1608Metric
U102: ICM-42688; QFN50P300X250X97-14N
U501: MPU9250; Axis

Connections:
+3V3: C105.1, C106.1, C108.1, J101.2, J102.2, J103.2, R101.2, U102.5 (VDDIO), U102.8 (VDD)
/INT1: J104.3, U102.4 (INT1)
/INT2: J104.4, U102.9 (INT2)
/SCL/SCK: J101.4, J102.4, J103.4, U102.13 (SCL)
/SDA/SDI: J101.3, J102.3, J103.3, U102.14 (SDA)
/SDO/AD0: J104.1, R101.1, U102.1 (AD0)
/~CS: J104.2, U102.12 (~CS)
GND: C105.2, C106.2, C108.2, J101.1, J102.1, J103.1, U102.6 (GND)
