kwan3217/rollercoasterometer/kicad/ICM-42688-P_breakout.kicad_pcb

## KiCad design kicad/ICM-42688-P_breakout.kicad_pcb (2022-04-15)

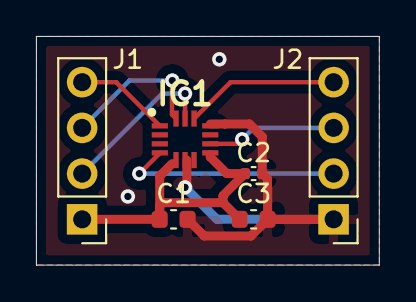
[picture p19: board ICM-42688-P_breakout.kicad_pcb from above]

Board: 2 copper layers, 19.0 x 12.7 mm, 6 parts (0 on the bottom side), 8 nets.

Parts:
C1: 0.01uF; C_0603_1608Metric
C2: 0.1uF; C_0402_1005Metric
C3: 22uF; C_0603_1608Metric
IC1: ICM-42688-P; QFN50P300X250X97-14N
J1, J2: Conn_01x04_Female; PinHeader_1x04_P2.54mm_Vertical

Connections:
unnamed: C1.1, C2.1, C3.1, IC1.5, IC1.8, J1.1
unnamed: C1.2, C2.2, C3.2, IC1.6, IC1.7, IC1.11, J2.1
unnamed: IC1.1, J1.4
unnamed: IC1.4, J2.2
unnamed: IC1.9, J2.3
unnamed: IC1.12, J2.4
unnamed: IC1.13, J1.2
unnamed: IC1.14, J1.3
