kwan3217/rollercoasterometer/(commit log)

2022-04-15 Added schematic blocks
    [AK09918C.kicad_sch, BMM150.kicad_sch, GPS_rover.kicad_sch, HiMag.kicad_sch, ICM-42688.kicad_sch, Shoe.kicad_sch, Shoulder.kicad_sch, USB+_cable.kicad_sch]
2022-04-15 Moved stuff into a kicad folder
    [AK09918C.kicad_sch, BMM150.kicad_sch, GPS_rover.kicad_sch, HiMag.kicad_sch, ICM-42688-P_breakout.kicad_pcb, ICM-42688.kicad_sch, Shoe.kicad_sch, Shoulder.kicad_sch]
2022-04-15 Added read_sensors Arduino sketch and ICM42688 breakout
    [ICM42688 breakout.kicad_pcb, ICM42688 breakout.kicad_sch]
2022-04-15 Adding teensy_loader_cli as a submodule
2022-04-15 Broke down sensor block into a tree of sheets
    [AK09918C.kicad_sch, BMM150.kicad_sch, GPS_rover.kicad_sch, HiMag.kicad_sch, ICM-42688.kicad_sch, Shoe.kicad_sch, USB+_cable.kicad_sch, bmp384.kicad_sch]
2022-04-15 Moved the Arduino sketch to its own folder, to satisfy the IDE
2022-04-18 One shining moment -- I2C_sensor lower-level stuff is working. Moving to different computer.
2022-04-18 Added USB+ breakout.
    [USB+ Breakout.kicad_pcb, USB+ Breakout.kicad_sch]
2022-04-18 Updated README.md
    This readme is pretty much a journal of my development of the firmware for the Teensy 4.1 that will be riding on the rollercoasterometer.
2022-04-19 Moved submodule to within kicad folder
2022-04-19 Added Digikey references
    [AK09918C.kicad_sch, BMM150.kicad_sch, HiMag.kicad_sch, i2c_level_shift.kicad_sch, regulator.kicad_sch, regulator_1v8.kicad_sch]
2022-04-19 One shining moment
    Commit board while it still works
    [GPS_rover.kicad_sch, ICM-42688.kicad_sch, Shoe.kicad_sch, Shoulder.kicad_sch, USB+_cable.kicad_sch, bmp384.kicad_sch, regulator.kicad_sch, regulator_1v8.kicad_sch]
2022-04-20 Added AVR sketches for reading out sensors
2022-04-20 Updated symbol
    This incorporates the change in the library, to offset the NC pins and satisfy the ERC
    [GPS_rover.kicad_sch]
2022-04-20 Added Digikey numbers and purposes to several parts
    [GPS_rover.kicad_sch]
2022-04-20 Changed value of R436
    This is the current limiter for the battery charging. It slows down the charging, in exchange for reducing the number of different components
    [GPS_rover.kicad_sch]
2022-04-20 Updated Digikey part numbers
    Darn supply chain crisis :(
    [i2c_level_shift.kicad_sch]
2022-04-20 Updated values for I2C pullup resistors
    This weakens the pullup a little bit in exchange for a reduced part count
    [i2c_level_shift.kicad_sch]
2022-04-20 Updated part numbers
    This sheet is included multiple times, and this time it decided to save with the references from a different instance.
    [i2c_level_shift.kicad_sch]
2022-04-20 Updated part number
    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
    [regulator.kicad_sch]
2022-04-20 Updated .gitignore to ignore bills of materials and project archives
2022-04-20 Updating PCB to follow schematic
    [rollercoasterometer.kicad_pcb]
2022-04-20 Updated graphical symbols
    [rollercoasterometer.kicad_sch]
2022-04-20 Updated Digikey part numbers
    [rollercoasterometer.kicad_sch]
2022-04-20 Changed resistor values to reduce component type count
    [rollercoasterometer.kicad_sch]
2022-04-20 Changed regulator manufacturer
    New parts with identical pinout
    [rollercoasterometer.kicad_sch]
2022-04-20 Updated graphical elements
    [Shoe.kicad_sch, Shoulder.kicad_sch]
2022-04-20 Changed protection diode for USB lines
    [Shoulder.kicad_sch]
2022-04-20 Updated Digikey part number
    [Shoulder.kicad_sch]
2022-04-20 Edited symbol to remove ERC violations
    Some of the overlapping NC pins were getting connected through the NC symbol (not connected to anything else, but connected to each other). This is fixed by editing this instance of the symbol and offsetting the pins from each other.
    [USB+_cable.kicad_sch]
2022-04-20 Updated PCB
    Updated ESD diode and routing of lines through it. Added corner silkscreen marks around all LGA/BGA parts, to allow easier inspection of placement before reflow.
    [rollercoasterometer.kicad_pcb]
2022-04-20 Updated which lines are used in 4-line protection diode
    [Shoulder.kicad_sch]
2022-04-24 Added a purpose field to bypass capacitors
    [AK09918C.kicad_sch, BMM150.kicad_sch, HiMag.kicad_sch, bmp384.kicad_sch]
2022-04-24 Updated purposes for regulators
    [regulator.kicad_sch, regulator_1v8.kicad_sch]
2022-04-25 Updated antenna chain
    Added a BOM-only part to give the actual antenna a Digikey reference that won't appear on the PCB. Added a solder jumper to control whether the antenna is powered. Removed 27R resistors for pins that are not in use.
    [GPS_rover.kicad_sch]
2022-04-25 Updated Digikey numbers
    [i2c_level_shift.kicad_sch]
2022-04-25 Corrected Digikey numbers
    Stupid supply chain :( . Updated protection diode for data lines. Removed heirarchical pins which are no longer present in the nested sheet.
    [Shoulder.kicad_sch]
2022-04-25 Added joystick board
    [joystick.kicad_sch]
2022-04-25 Updated PCB to follow schematic changes
    [rollercoasterometer.kicad_pcb]
2022-04-25 Added reference to USB cable on BOM
    [USB+_cable.kicad_sch]
2022-04-25 Updated LEDs and edge cutouts
    [USB+ Breakout.kicad_pcb, USB+ Breakout.kicad_sch]
2022-04-25 Added reference to TeensyView
    TeensyView does not get a footprint because it mounts on top of the Teensy, but it is hooked up to the schematic properly.
    [rollercoasterometer.kicad_sch]
2022-04-25 Replaced JS5208 with smaller JS1400
    [joystick.kicad_sch, rollercoasterometer.kicad_pcb, rollercoasterometer.kicad_sch]
2022-04-25 Added joystick as a STEP part and used it as part of Teensy 3D model
    The whole board was saved as joystick.kicad_pcb. The parts of the board that are not part of the joystick board were removed. The board was then washed through the Freecad plugin KicadStepUp to convert to STEP.
    [USB+_cable.kicad_sch, joystick.step, rollercoasterometer.kicad_pcb]
2022-04-28 Added graphical components to schematic for joystick board
    [joystick.kicad_sch]
2022-04-28 Numbering change
    [USB+_cable.kicad_sch, i2c_level_shift.kicad_sch]
2022-04-28 Added pocket case design files
    [Pocket Case-Hole.step, Pocket Case-Joystick.step, Pocket Case-Plate.step, Pocket Case-Slot.step, Pocket Case-ThroughHoleSlots.step, Pocket Case-USBPlus.step, Pocket Case-USBSlot.step, Pocket Case.FCStd]
2022-04-28 Moved USB+ connectors to bottom of board
    [rollercoasterometer.kicad_pcb, rollercoasterometer.kicad_sch]
2022-04-29 Added a NC to the board
    [USB+_cable.kicad_sch, joystick.kicad_sch, rollercoasterometer.kicad_pcb, rollercoasterometer.kicad_sch]
2022-05-14 Import from arduino-1.8.19/hardware/teensy/avr/cores/teensy4
2022-12-18 Checkin before branch
    [AK09918C.kicad_sch, BMM150.kicad_sch, GPS_rover.kicad_sch, HiMag.kicad_sch, ICM-42688.kicad_sch, bmp384.kicad_sch, i2c_level_shift.kicad_sch, joystick.kicad_sch]
2022-12-18 Added rollercoasterometer_hat before branch
    [AK09918C.kicad_sch, BMM150.kicad_sch, ICM-42688.kicad_sch, LPC214x.kicad_sch, USB+_cable.kicad_sch, bmp384.kicad_sch, featherM0.kicad_sch, featherM4.kicad_sch]
2022-12-18 Track current version of submodule
